JarolNM/Diseno-Circuitos-Medidor-Resistencia-IoT/figuras/esquematico_completo.png

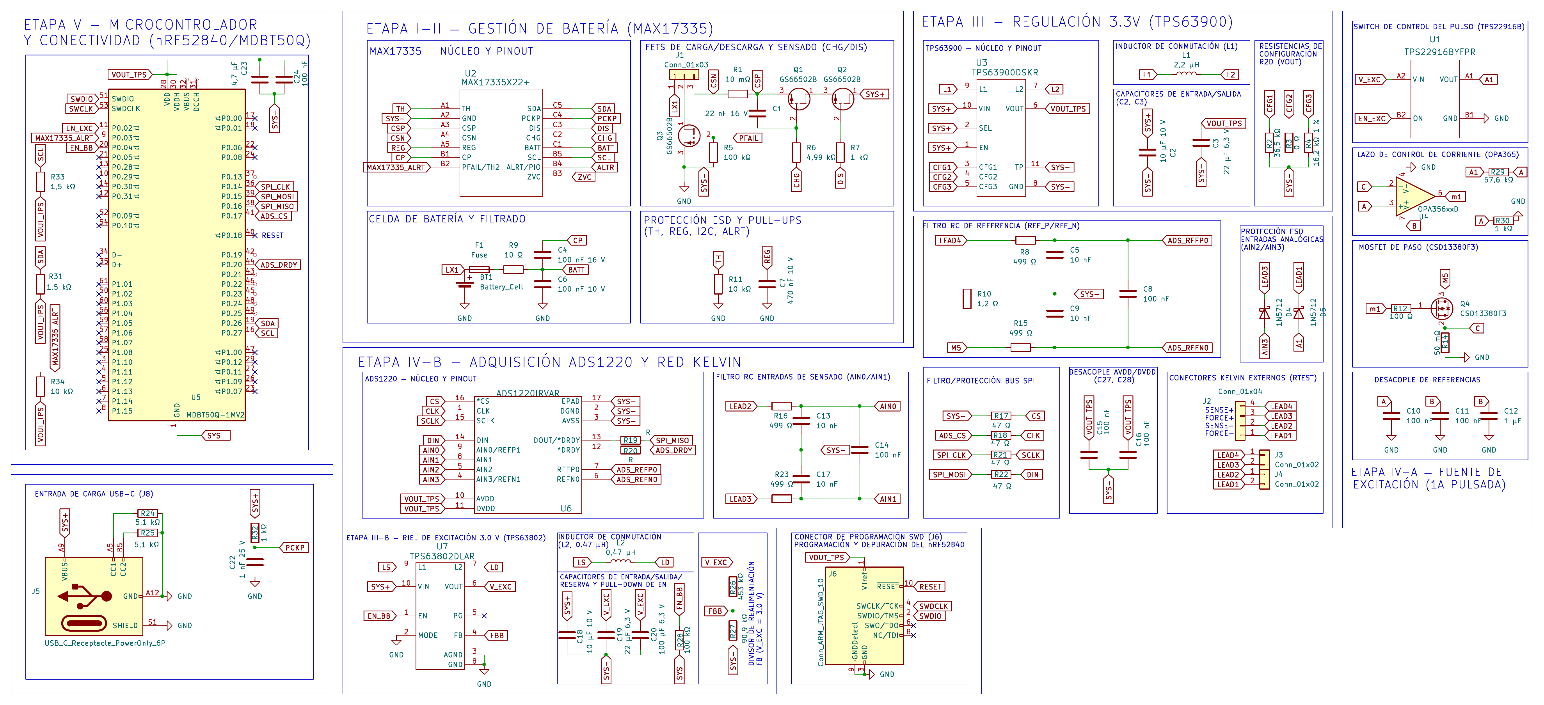
figuras/esquematico_completo.png
