JarolNM/Diseno-Circuitos-Medidor-Resistencia-IoT/esquematico_completo.pdf

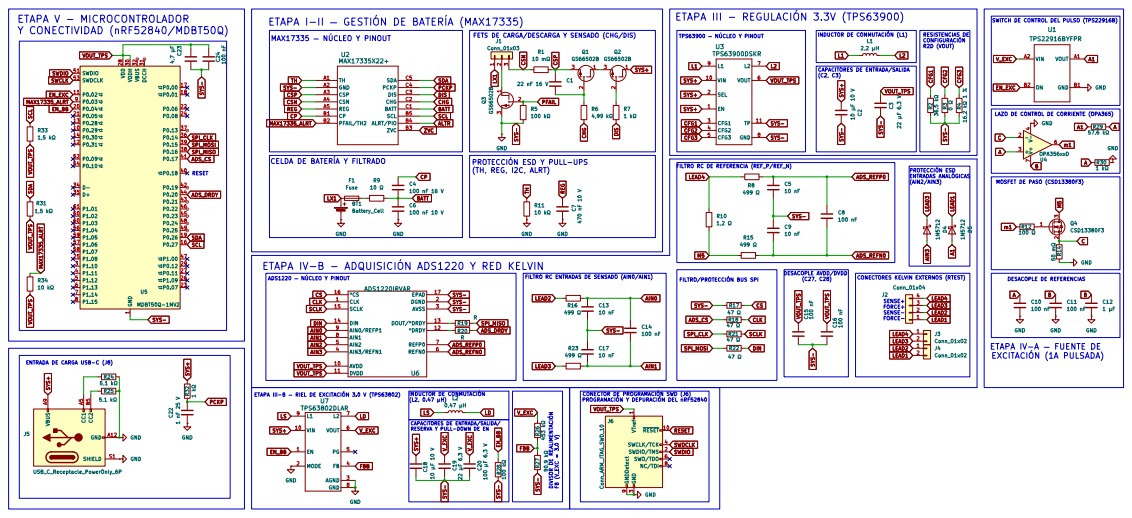
[picture p6: page 1]
