JarolNM/Diseno-Circuitos-Medidor-Resistencia-IoT/esquematico beta.pdf

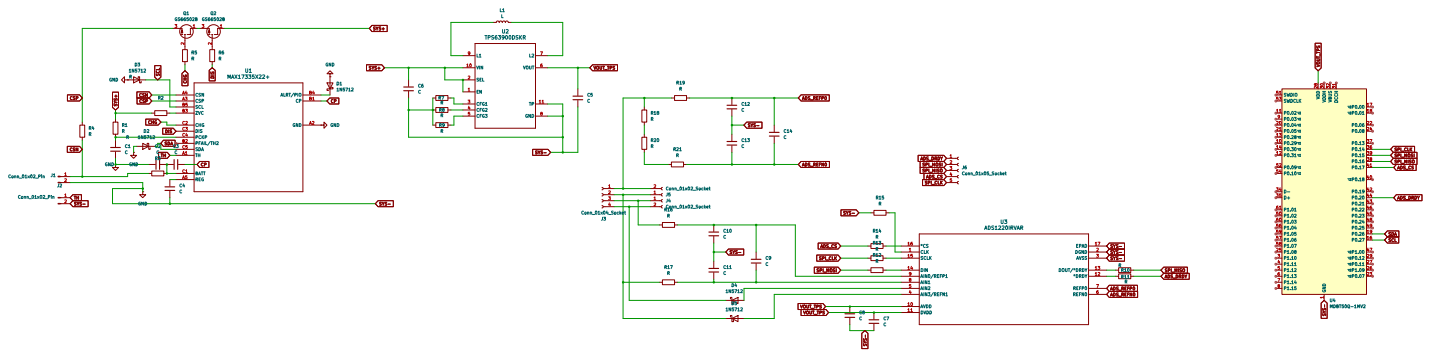
[picture p7: page 1]
