JarolNM/Diseno-Circuitos-Medidor-Resistencia-IoT/(commit log)

2026-09-11 Actualización: README principal con descripción de integrados
2026-09-11 Actualización: Estructura de investigación y solución seleccionada ADS1220
2026-09-11 Actualización: Estructura de investigación de microcontrolador y BLE vs WiFi
2026-09-11 Actualización: Estructura de investigación y solución seleccionada MAX17335
2026-09-11 Actualización: Estructura de investigación y solución seleccionada TPS63900
2026-09-11 Limpieza: Dejar main unicamente con el README
